abhiterala-del/BrailLink/docs/README.md

# docs

- [Assembly guide](assembly.md)

Photos go in `images/`.
