abhiterala-del/BrailLink/hardware/cad/step/brailink-full-assembly.step

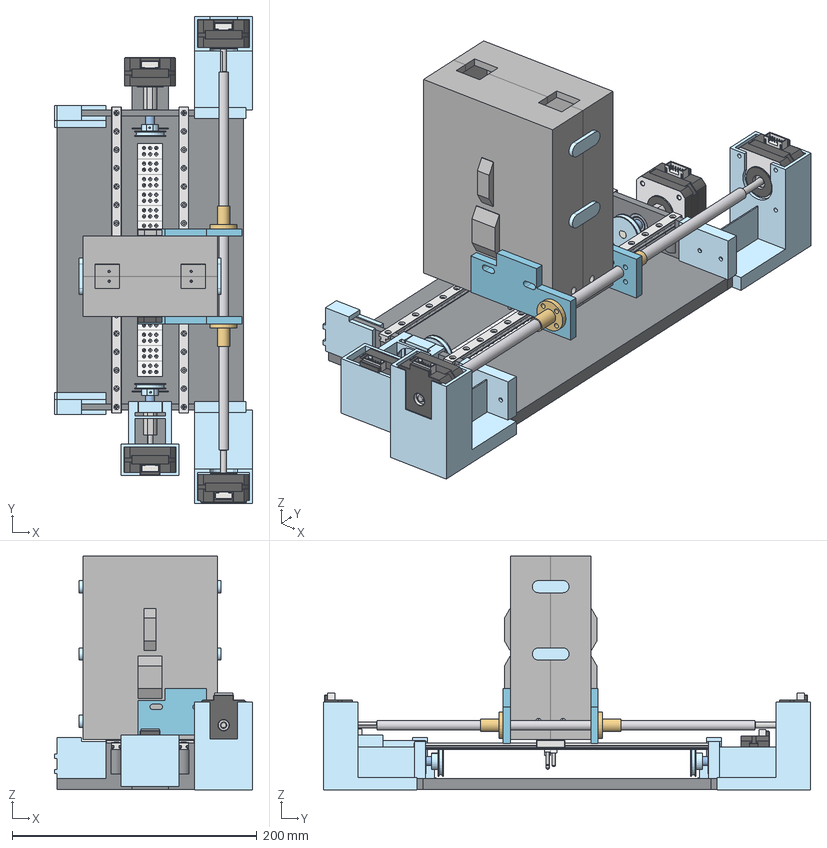
[picture p2: CAD file, 2026-03-13]
hardware/cad/step/brailink-full-assembly.step
161.8 x 397.6 x 191.0 mm
die x 15
Punch Head Nut Bracket - Alignment Slots
Punch Head Nut Bracket - Other Head End
Lead Screw Nut - Other Head End
id105 x 2
id110 x 2
id115 x 2
id120 x 2
id125 x 2
id130 x 2
id135 x 2
id140 x 2
id145 x 2
id150 x 2
id155 x 2
id160 x 2
connector x 4
M3_screw x 16
back_plate x 4
stator x 4
rotor x 4
625ZZ x 8
front_plate x 4
Lead Screw Nut - Hardware Envelope
punch x 6
MG995 x 6
Spur gear (15 teeth) x 6
Lead Screw - Parametric Hardware Envelope
