abhiterala-del/BrailLink/hardware/cad/stl/PRINT_09_Side_Bearing_Clip_qty1.stl

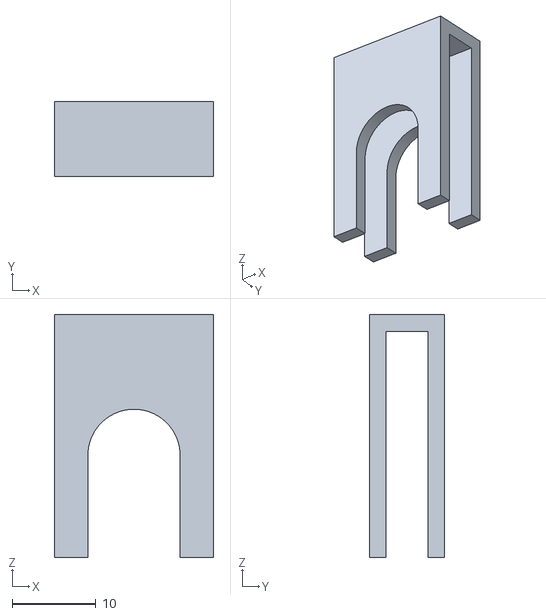
[picture p3: CAD file, 2026-03-13]
hardware/cad/stl/PRINT_09_Side_Bearing_Clip_qty1.stl
19.0 x 9.00 x 29.0
