abhiterala-del/BrailLink/hardware/cad/stl/PRINT_04_Wall_B_qty1.stl

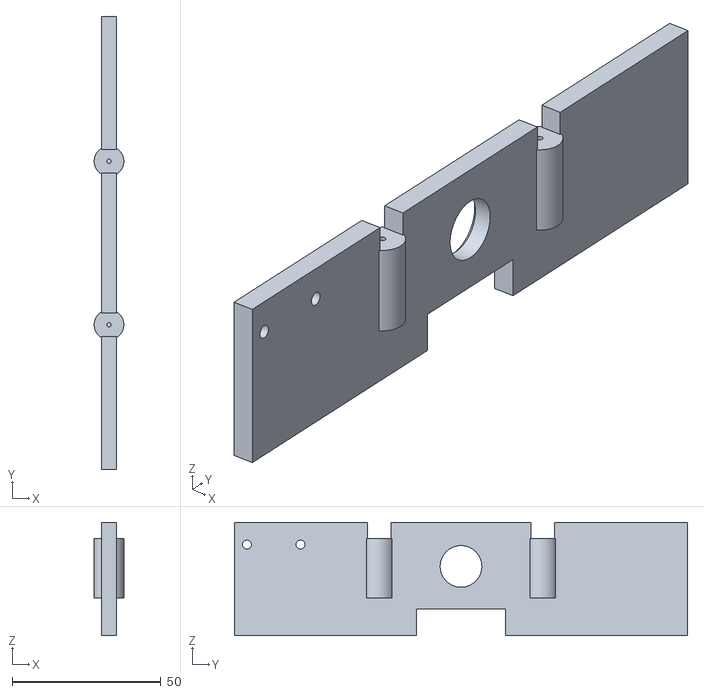
[picture p4: CAD file, 2026-03-13]
hardware/cad/stl/PRINT_04_Wall_B_qty1.stl
10.00 x 152.4 x 38.1
