abhiterala-del/BrailLink/hardware/cad/stl/PRINT_12_Paper_Alignment_Clip_Part2_qty1.stl

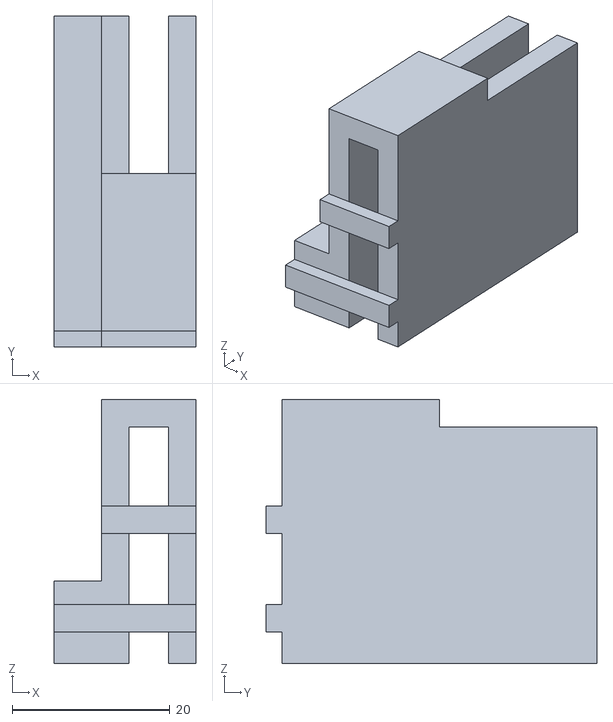
[picture p5: CAD file, 2026-03-13]
hardware/cad/stl/PRINT_12_Paper_Alignment_Clip_Part2_qty1.stl
18.0 x 42.0 x 33.5
