abhiterala-del/BrailLink/hardware/cad/stl/PRINT_15_Paper_Advance_Shaft_Part1_qty2.stl

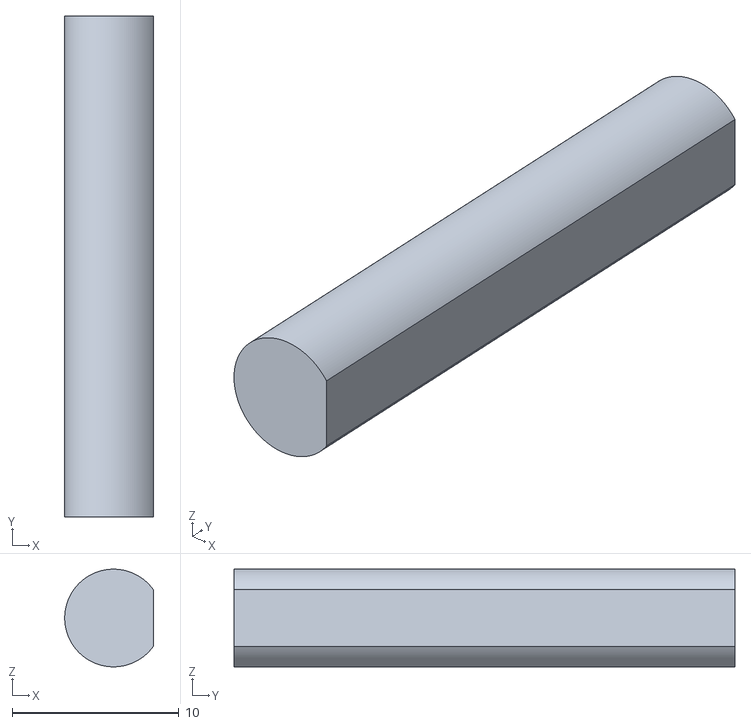
[picture p6: CAD file, 2026-03-13]
hardware/cad/stl/PRINT_15_Paper_Advance_Shaft_Part1_qty2.stl
5.31 x 30.0 x 5.85
