abhiterala-del/BrailLink/hardware/cad/stl/PRINT_10_Side_Motor_Holder_qty1.stl

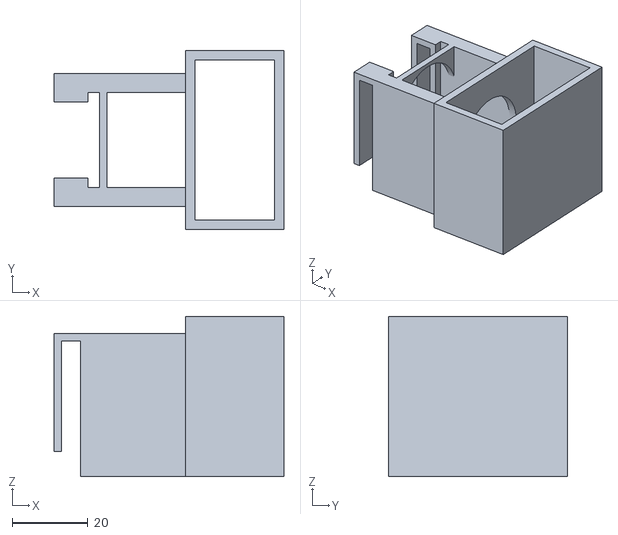
[picture p7: CAD file, 2026-03-13]
hardware/cad/stl/PRINT_10_Side_Motor_Holder_qty1.stl
60.6 x 47.3 x 42.3
