abhiterala-del/BrailLink/hardware/cad/stl/PRINT_23_Rack_150mm_qty2.stl

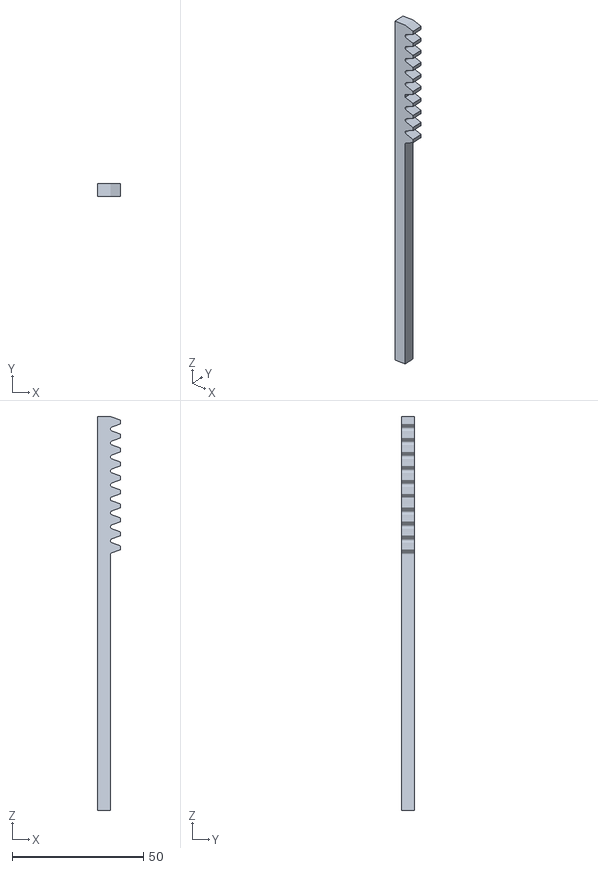
[picture p8: CAD file, 2026-03-13]
hardware/cad/stl/PRINT_23_Rack_150mm_qty2.stl
8.81 x 5.00 x 150.0
