abhiterala-del/BrailLink/hardware/cad/stl/PRINT_20_Punch_Head_Case_qty2.stl

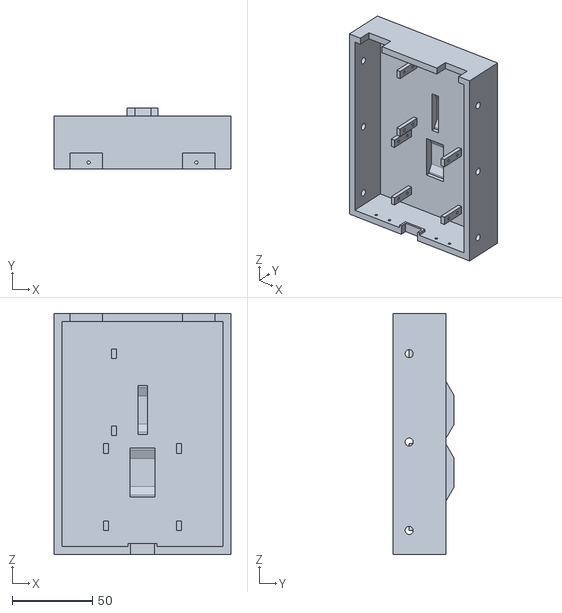
[picture p9: CAD file, 2026-03-13]
hardware/cad/stl/PRINT_20_Punch_Head_Case_qty2.stl
110.0 x 37.8 x 150.0
