abhiterala-del/BrailLink/hardware/cad/stl/PRINT_02_Die_Block_qty17.stl

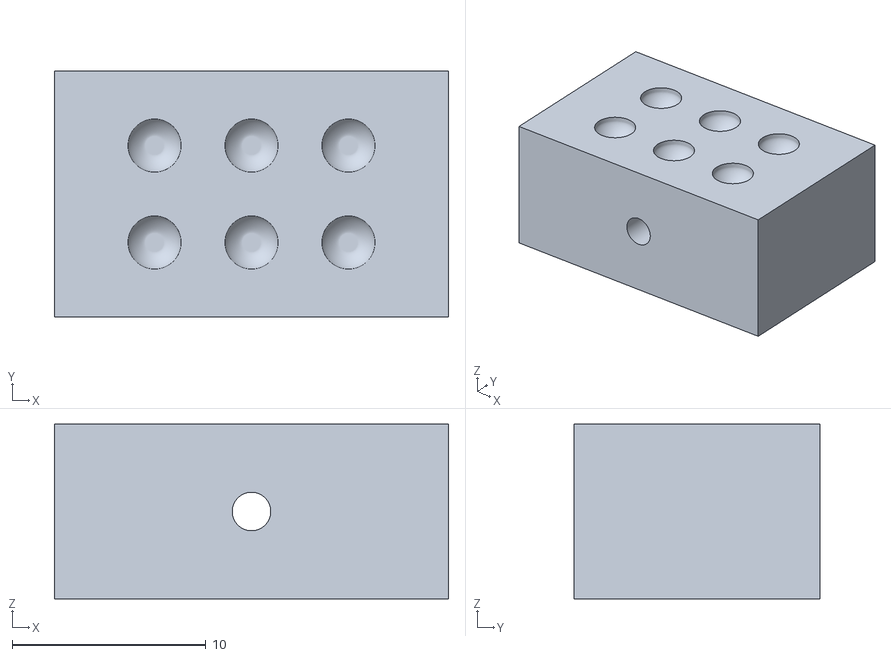
[picture p10: CAD file, 2026-03-13]
hardware/cad/stl/PRINT_02_Die_Block_qty17.stl
20.3 x 12.7 x 9.00
