abhiterala-del/BrailLink/hardware/cad/stl/PRINT_08_Other_Side_Motor_Mount_Part2_qty1.stl

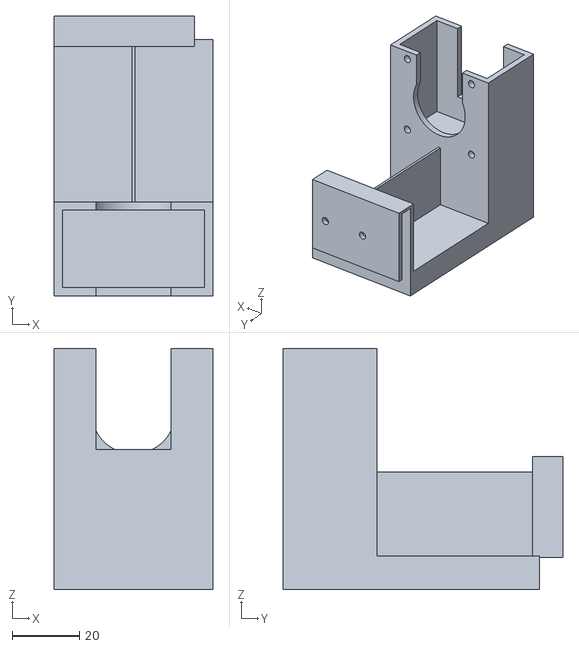
[picture p11: CAD file, 2026-03-13]
hardware/cad/stl/PRINT_08_Other_Side_Motor_Mount_Part2_qty1.stl
47.3 x 83.3 x 71.8
