abhiterala-del/BrailLink/hardware/cad/stl/PRINT_01_Base_Plate_qty1.stl

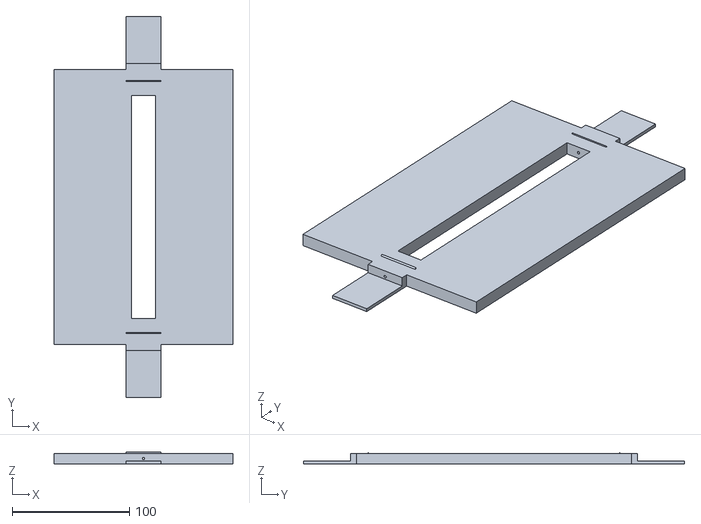
[picture p12: CAD file, 2026-03-13]
hardware/cad/stl/PRINT_01_Base_Plate_qty1.stl
152.4 x 325.0 x 10.0
