abhiterala-del/BrailLink/hardware/cad/stl/PRINT_06_Side_Clip_qty5.stl

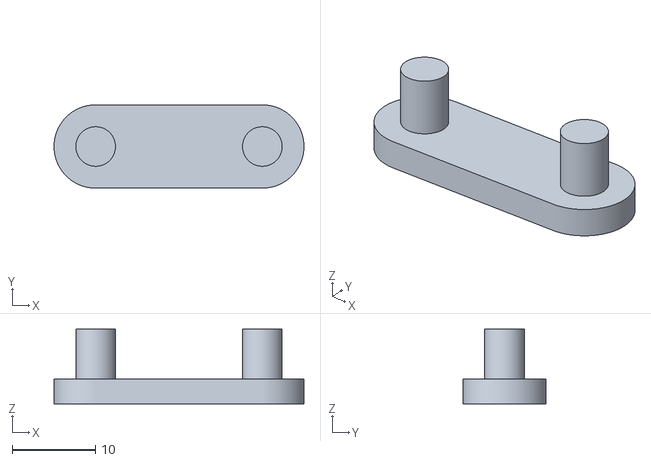
[picture p13: CAD file, 2026-03-13]
hardware/cad/stl/PRINT_06_Side_Clip_qty5.stl
30.0 x 10.0 x 9.00
