abhiterala-del/BrailLink/hardware/cad/stl/PRINT_16_Shaft_Spacer_qty2.stl

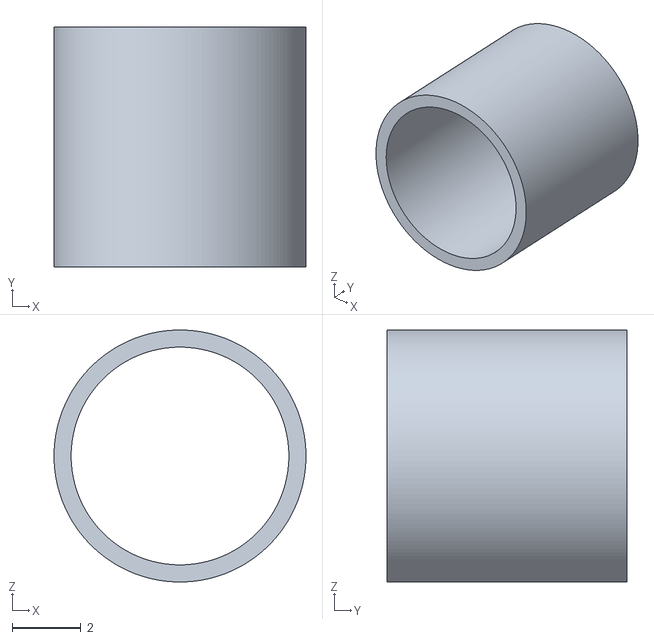
[picture p14: CAD file, 2026-03-13]
hardware/cad/stl/PRINT_16_Shaft_Spacer_qty2.stl
7.35 x 7.00 x 7.35
