abhiterala-del/BrailLink/hardware/cad/stl/PRINT_18_Paper_Advance_Shaft_Part2_qty2.stl

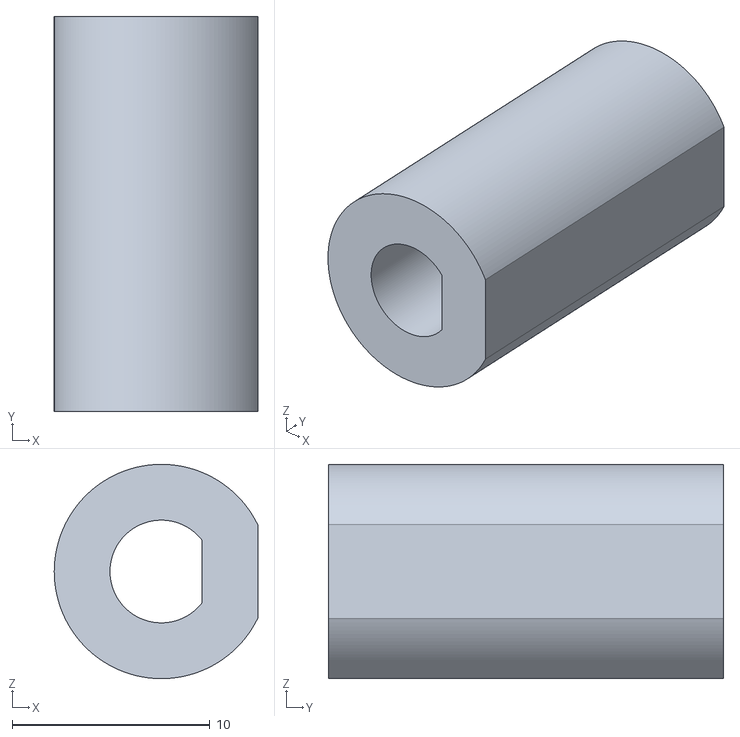
[picture p15: CAD file, 2026-03-13]
hardware/cad/stl/PRINT_18_Paper_Advance_Shaft_Part2_qty2.stl
10.3 x 20.0 x 10.8
