abhiterala-del/BrailLink/hardware/cad/stl/PRINT_22_Rack_110mm_qty4.stl

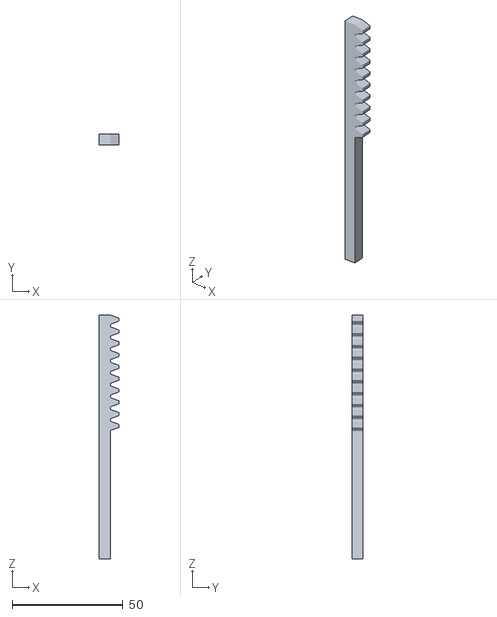
[picture p16: CAD file, 2026-03-13]
hardware/cad/stl/PRINT_22_Rack_110mm_qty4.stl
8.81 x 5.00 x 110.0
