abhiterala-del/BrailLink/hardware/cad/stl/PRINT_21_Punch_qty6.stl

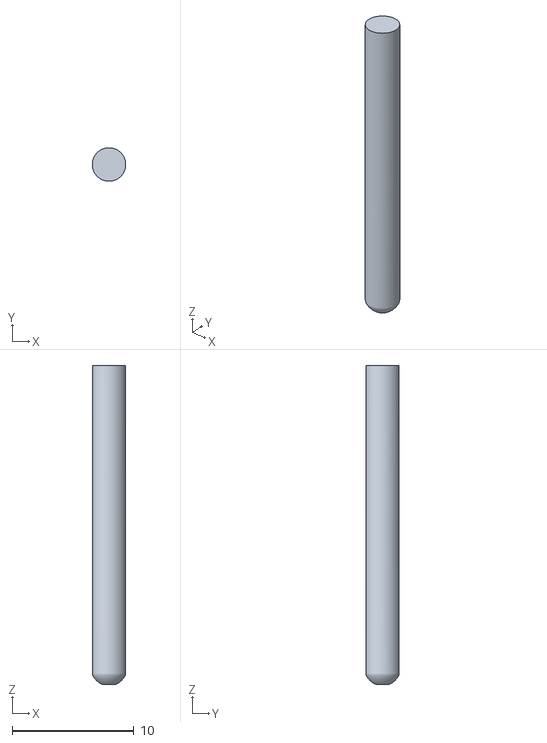
[picture p17: CAD file, 2026-03-13]
hardware/cad/stl/PRINT_21_Punch_qty6.stl
2.75 x 2.75 x 26.2
