abhiterala-del/BrailLink/hardware/cad/stl/PRINT_17_Friction_Wheel_qty2.stl

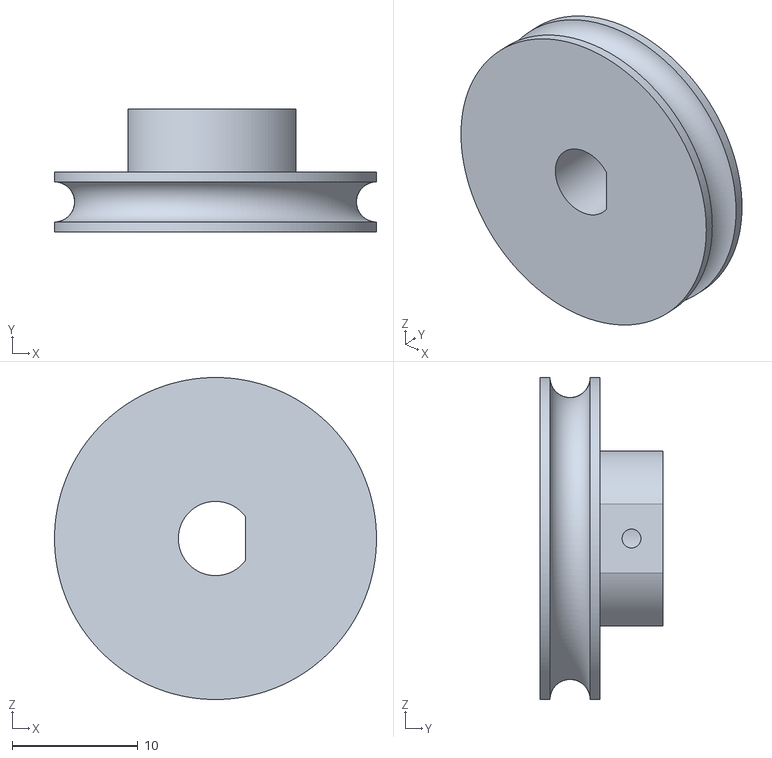
[picture p18: CAD file, 2026-03-13]
hardware/cad/stl/PRINT_17_Friction_Wheel_qty2.stl
25.6 x 9.78 x 25.6
