abhiterala-del/BrailLink/hardware/cad/stl/PRINT_19_Punch_Spur_Gear_15T_qty6.stl

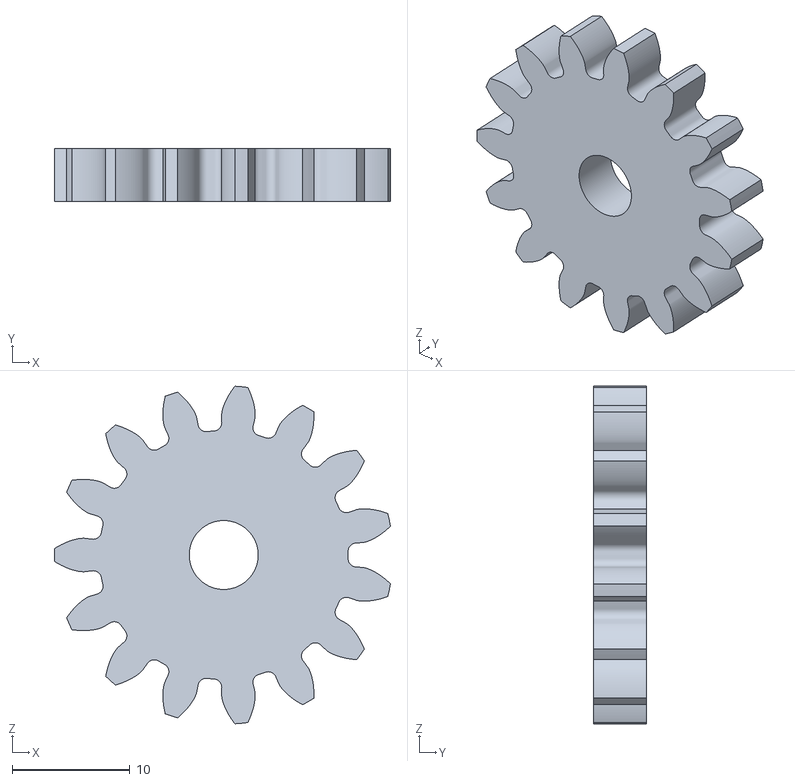
[picture p19: CAD file, 2026-03-13]
hardware/cad/stl/PRINT_19_Punch_Spur_Gear_15T_qty6.stl
28.6 x 4.50 x 28.7
