abhiterala-del/BrailLink/(list of files, cad)

Other CAD files:
hardware/cad/stl/PRINT_11_Paper_Alignment_Clip_Part1_qty1.stl
hardware/cad/stl/PRINT_03_Wall_A_qty1.stl
hardware/cad/stl/PRINT_07_Other_Side_Motor_Mount_Part1_qty1.stl
hardware/cad/stl/PRINT_13_Head_Nut_Bracket_First_End_qty1.stl
hardware/cad/stl/PRINT_14_Head_Nut_Bracket_Other_End_qty1.stl
